biletnikov/BathroomController/version2/Schematic_BathroomController-v2_schema.pdf

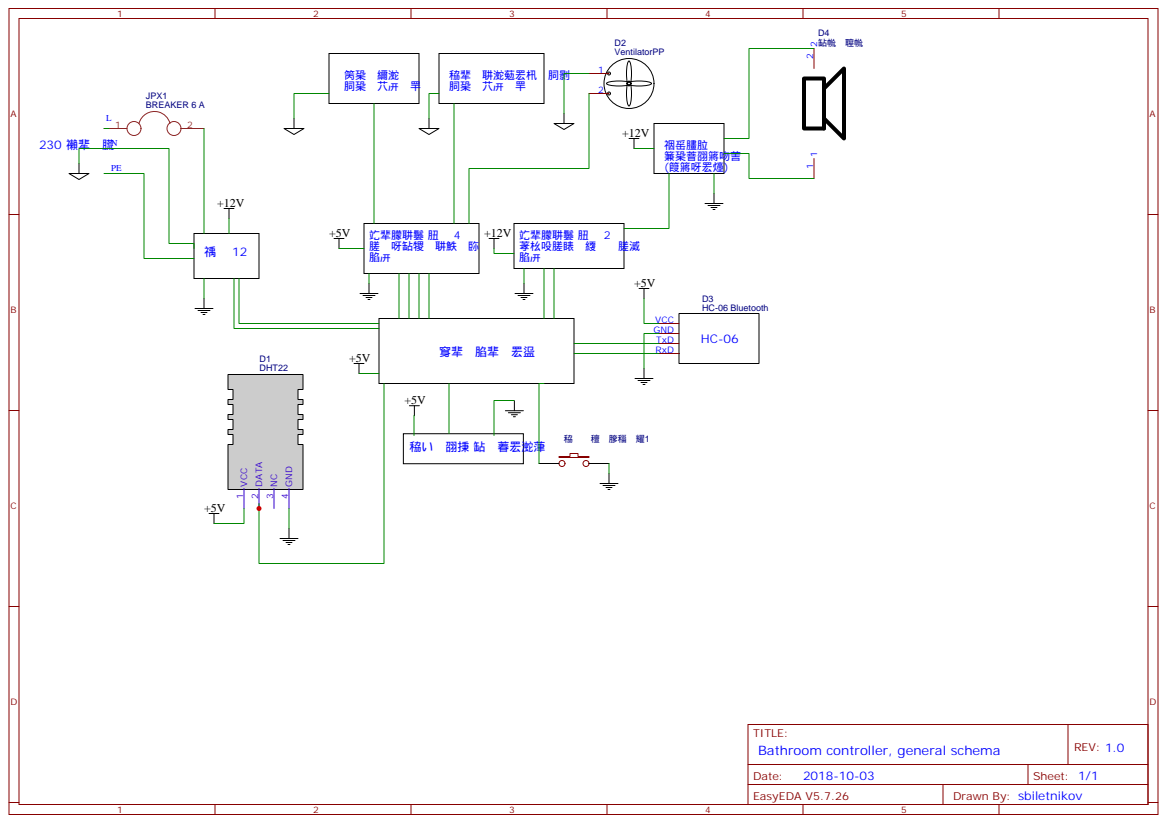
[picture p1: page 1]

TITLE:
Bathroom controller, general schema

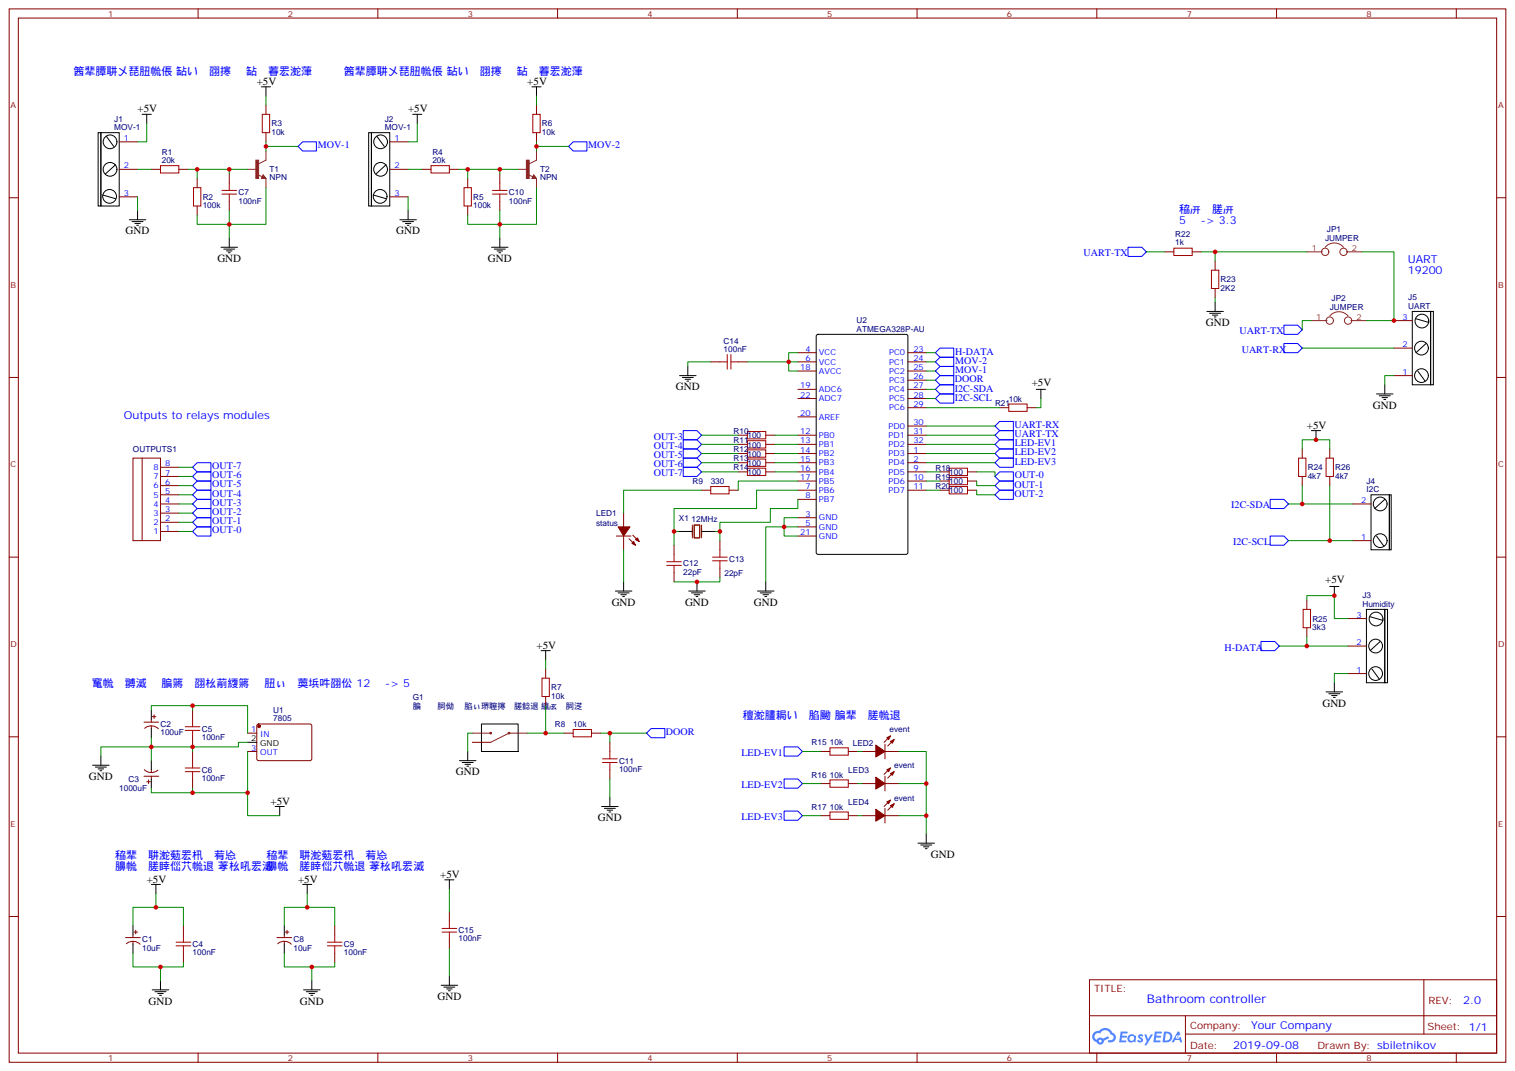
[picture p2: page 2]

Outputs to relays modules

䆴㡃퐵䎔㵄됹 䐔䉃б䎄㭃萷䌄䉃 䏔ぃ䓴㙃吽䎄伀 12 -> 5
