biletnikov/BathroomController/(list of files, drawings)

Other design files:
version1/BathroomController.DSN
version1/BathroomController.pdsprj
version1/BathroomController_Board.lay6
version1/BathroomController_Board_2.lay6
version2/BathroomController/Main-Board-JLCPCB.lay6
version2/BathroomController/Main-Board.lay6
